RBSC/OmniSCC/enclosure/carts_v2.3mf

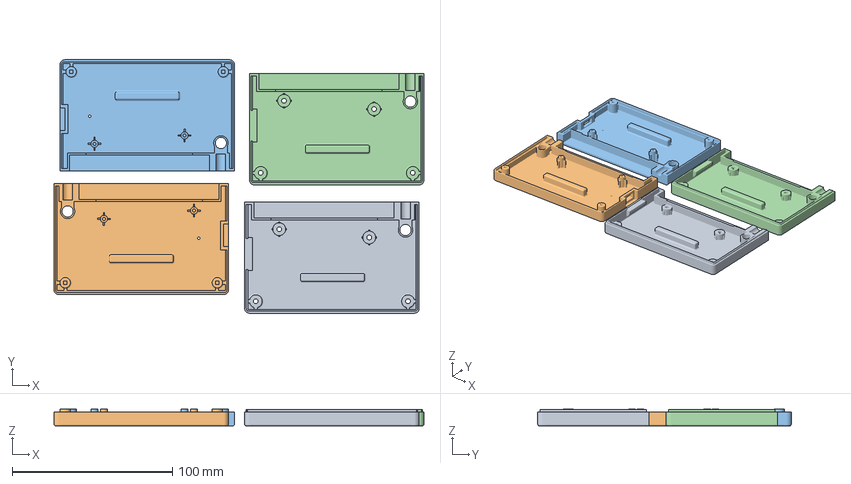
[picture p1: CAD file, 2026-10-27]
enclosure/carts_v2.3mf
231.1 x 158.3 x 10.5 mm
bot2_V2-1 x 2
top_V2-1 OmniSCC
top_V2-1 OmniSCC+
