RBSC/OmniSCC/enclosure/carts_v1.3mf

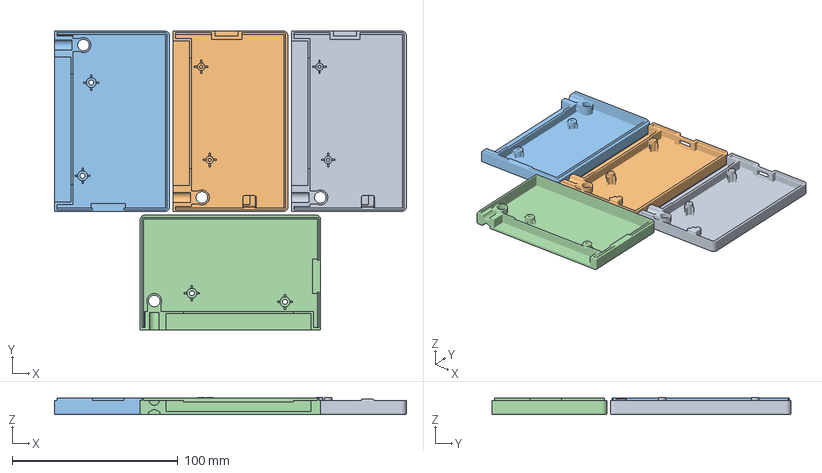
[picture p2: CAD file, 2026-10-27, an earlier design]
enclosure/carts_v1.3mf
212.5 x 180.5 x 10.5 mm
top_print_v4 x 2
bot_print_v4 x 2
